BerkeleyCurtis/EECS249_HapticGlove/Sketches/Sketch1_PoC.jpg

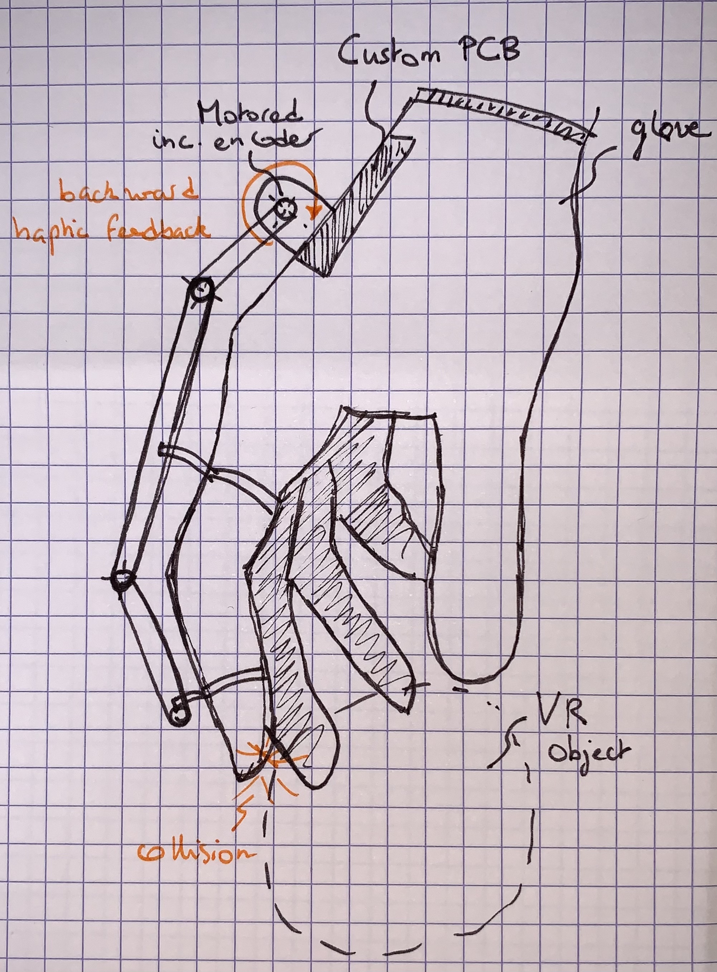
Sketches/Sketch1_PoC.jpg
