BerkeleyCurtis/EECS249_HapticGlove/CAD Models/Finger Servo Bracket.png

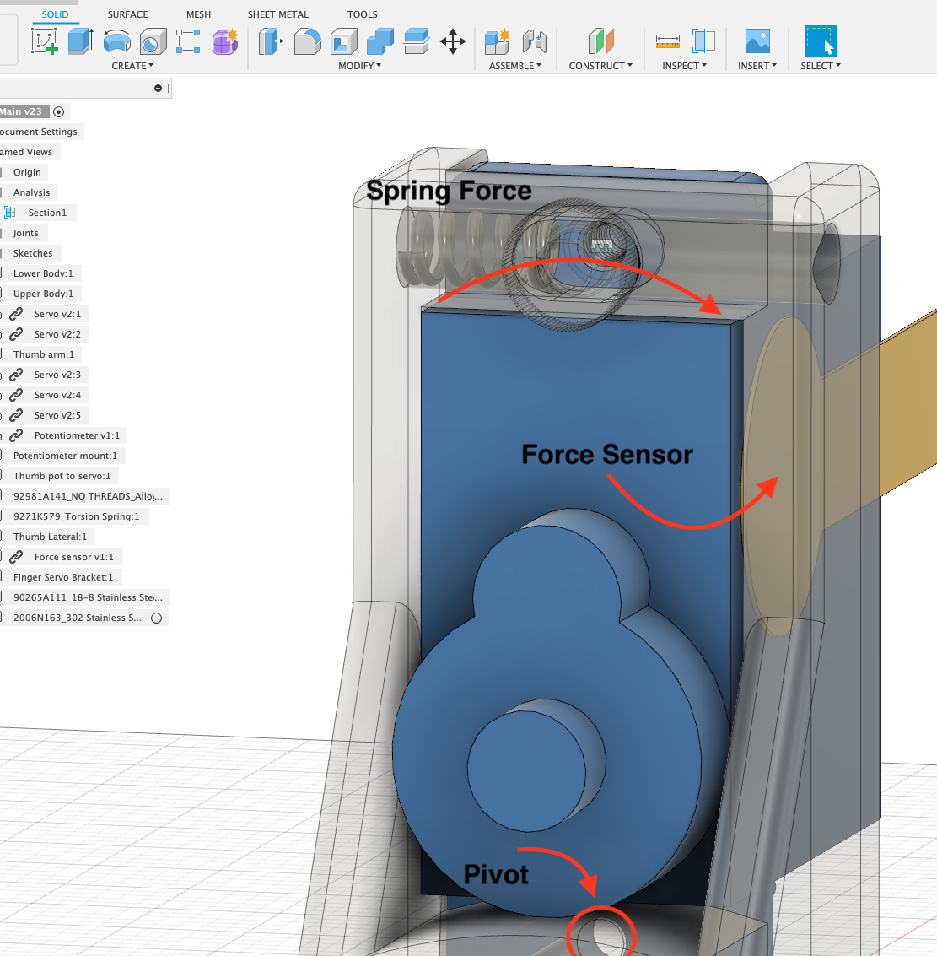
CAD Models/Finger Servo Bracket.png
