BerkeleyCurtis/EECS249_HapticGlove/Sketches/Architecture diag.pptx

RCA+RCD

IMU

Custom PCB

Micro USB

UART protocole

Computer Vision

Camera

USB

ESP32

Local machine

Optical flux

Robotic arm

Force sensor

ESP32 devkit

Force flux

GPIO

Object
