BerkeleyCurtis/EECS249_HapticGlove/PCB Files/Final PCB.png

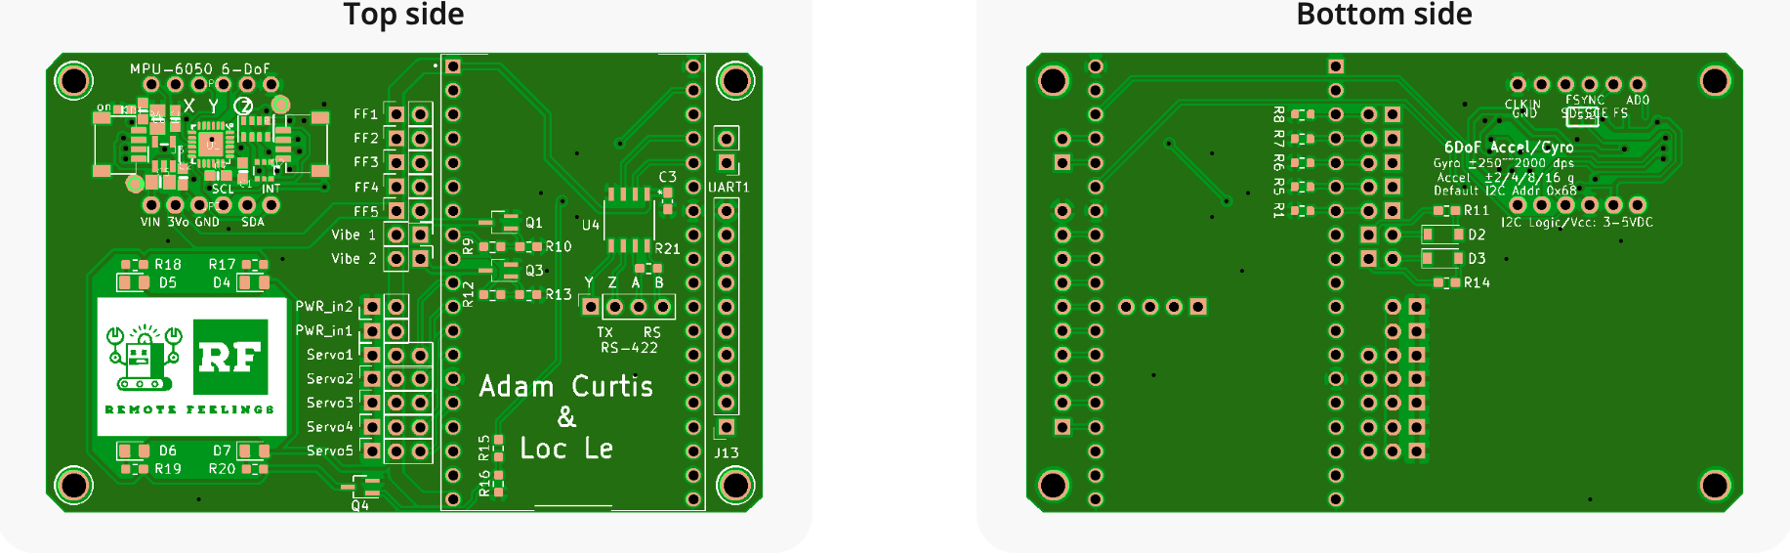
PCB Files/Final PCB.png
