BerkeleyCurtis/EECS249_HapticGlove/Sketches/Remote Feelings concurrent FSM.png

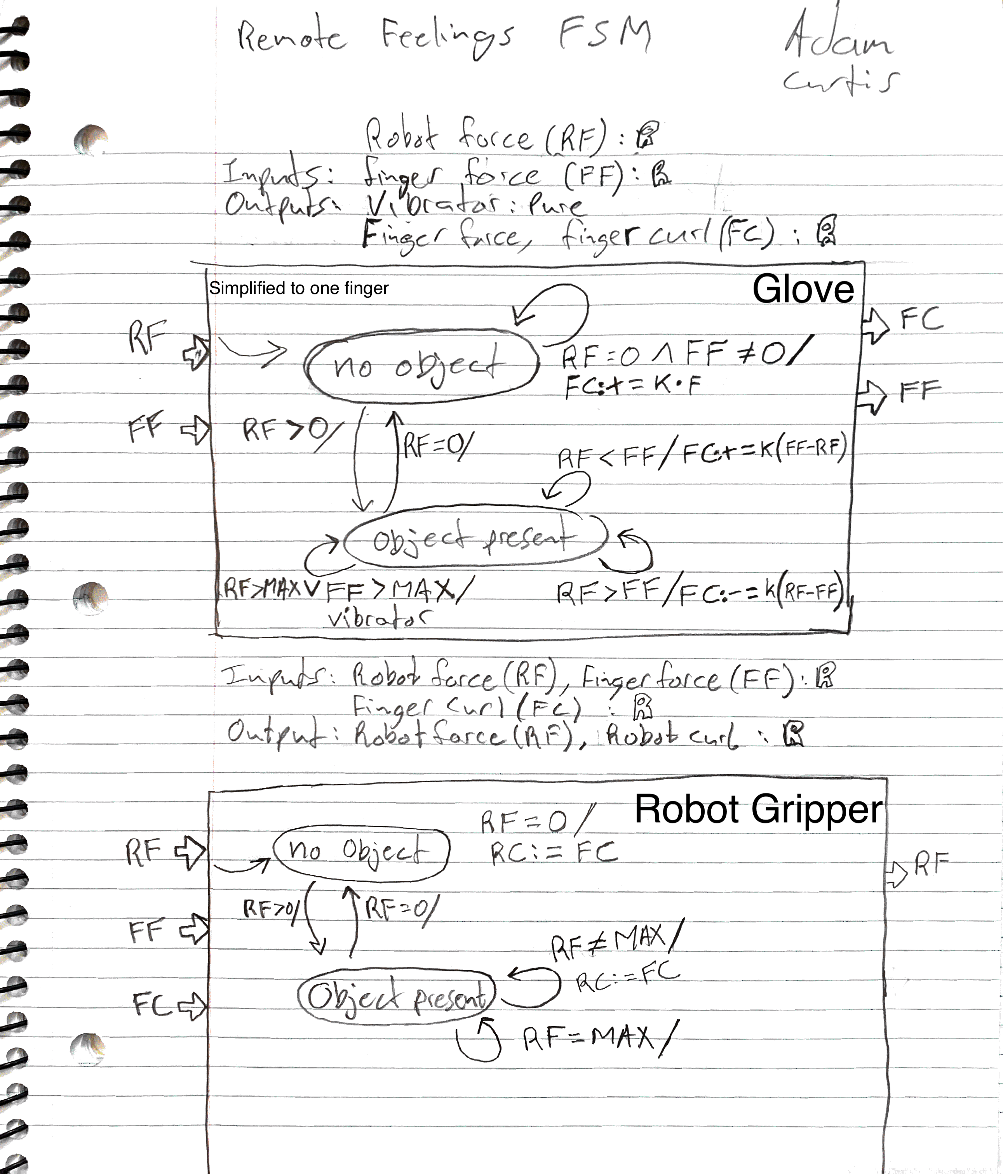
Sketches/Remote Feelings concurrent FSM.png
