BerkeleyCurtis/EECS249_HapticGlove/Sketches/System Diagram.png

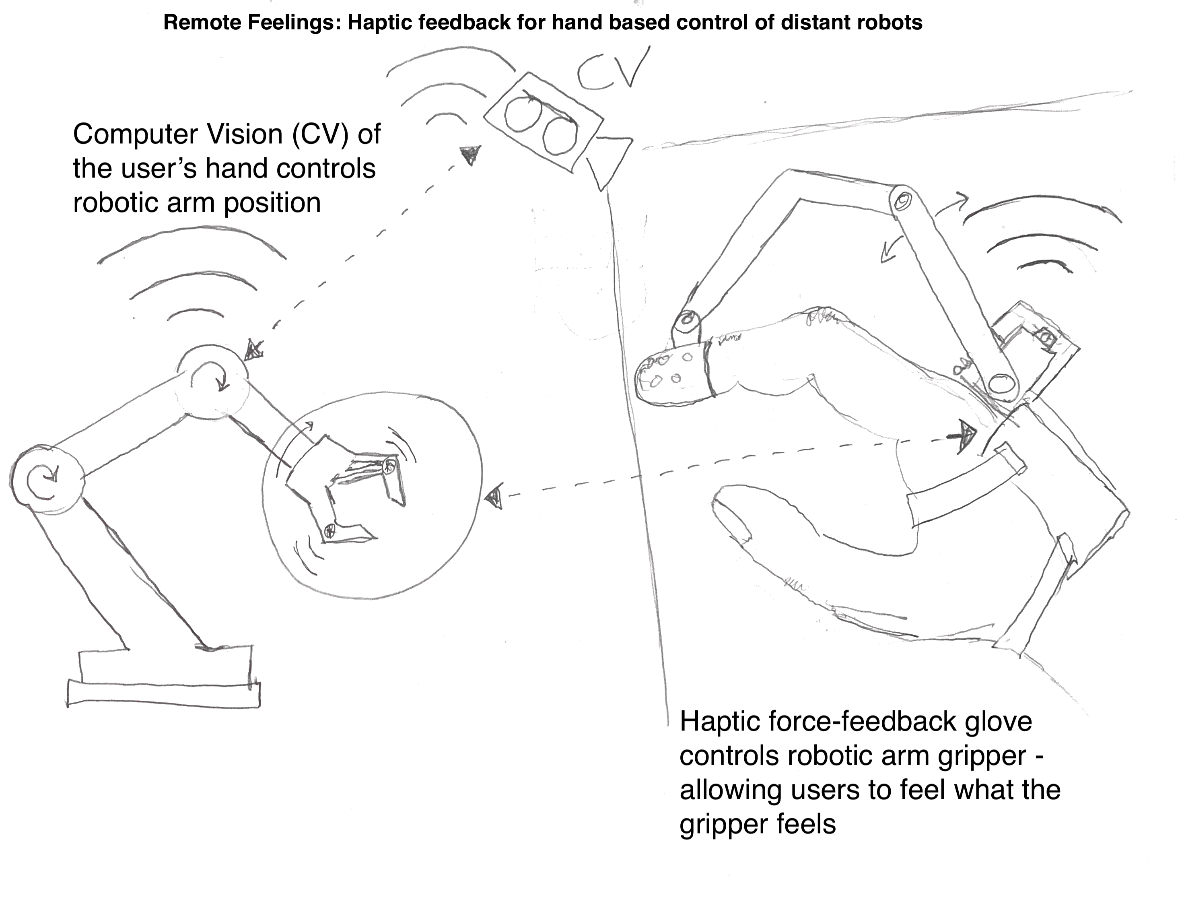
Sketches/System Diagram.png
