BerkeleyCurtis/EECS249_HapticGlove/Remote Feelings STLs/V2/Lower Main R-Hand 2.stl

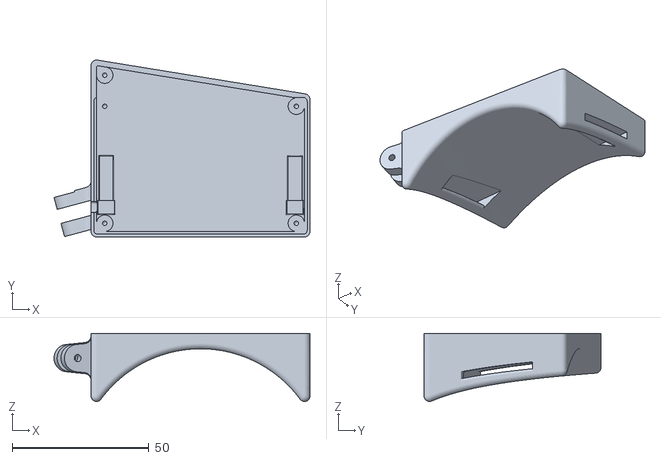
[picture p14: CAD file, 2021-12-15]
Remote Feelings STLs/V2/Lower Main R-Hand 2.stl
93.5 x 64.6 x 24.9
