BerkeleyCurtis/EECS249_HapticGlove/Remote Feelings STLs/V2/Upper Main R-Hand.stl

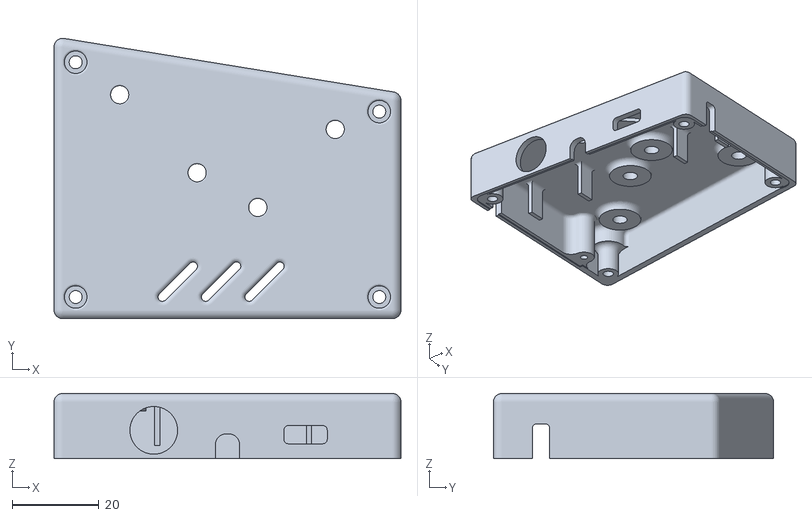
[picture p15: CAD file, 2021-12-15]
Remote Feelings STLs/V2/Upper Main R-Hand.stl
80.0 x 64.6 x 15.0
