BerkeleyCurtis/EECS249_HapticGlove/Remote Feelings STLs/V2/Index R-hand 2.stl

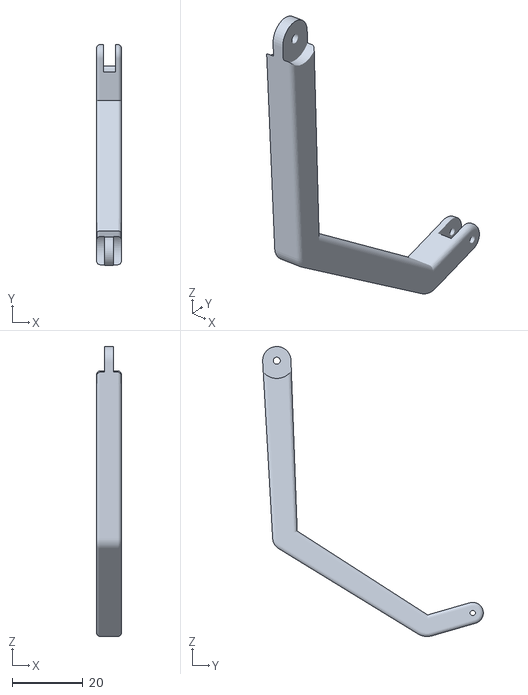
[picture p16: CAD file, 2021-12-15]
Remote Feelings STLs/V2/Index R-hand 2.stl
7.00 x 62.2 x 81.7
