BerkeleyCurtis/EECS249_HapticGlove/Remote Feelings STLs/V2/Thumb Bones 2.stl

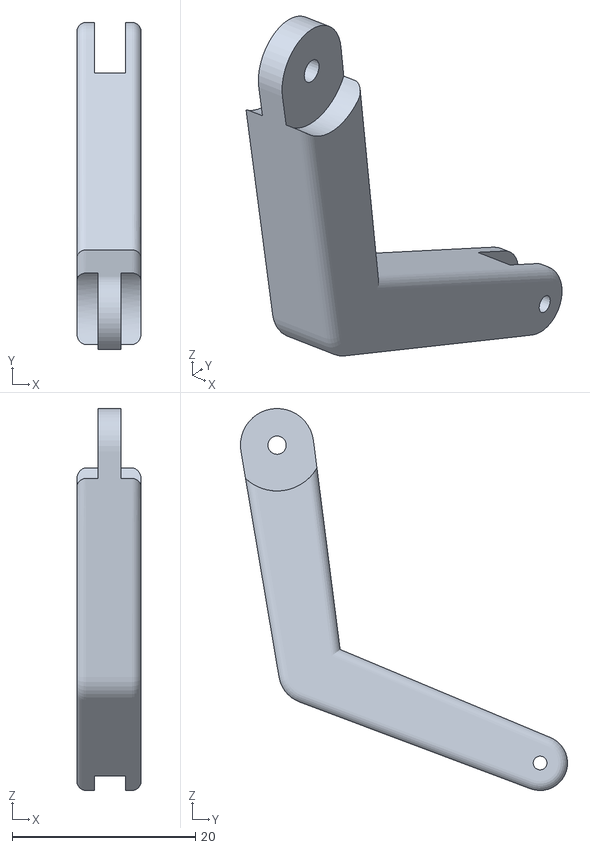
[picture p17: CAD file, 2021-12-15]
Remote Feelings STLs/V2/Thumb Bones 2.stl
7.00 x 35.7 x 41.7
