BerkeleyCurtis/EECS249_HapticGlove/Remote Feelings STLs/V2/Nano BLE Sense Mount.stl

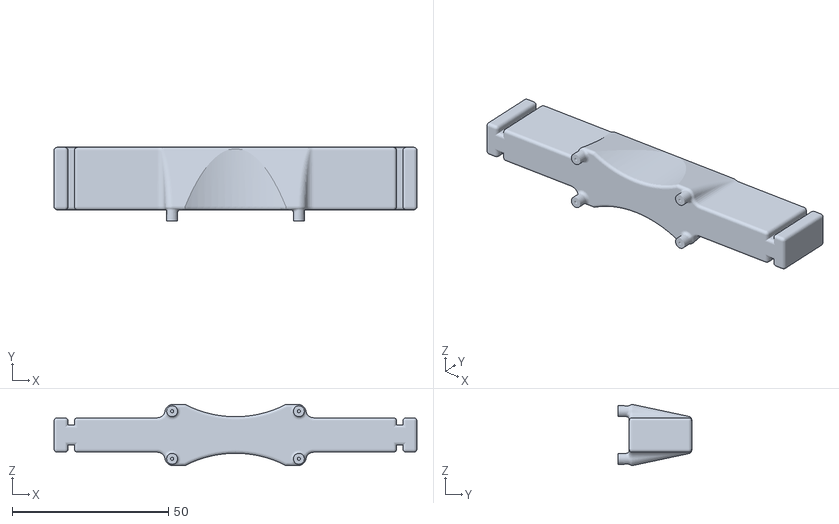
[picture p18: CAD file, 2021-12-15]
Remote Feelings STLs/V2/Nano BLE Sense Mount.stl
116.0 x 23.5 x 19.5
