BerkeleyCurtis/EECS249_HapticGlove/Remote Feelings STLs/V2/Thumb Arm.stl

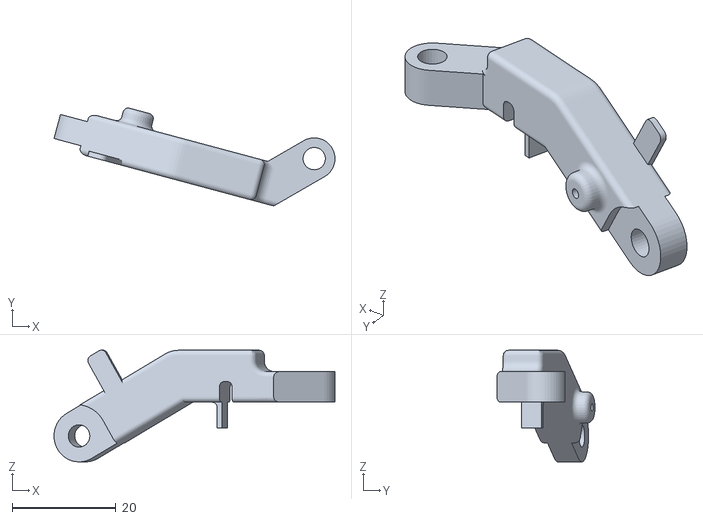
[picture p19: CAD file, 2021-12-15]
Remote Feelings STLs/V2/Thumb Arm.stl
54.1 x 18.9 x 21.5
