BerkeleyCurtis/EECS249_HapticGlove/Remote Feelings STLs/V2/R-Thumb bone short.stl

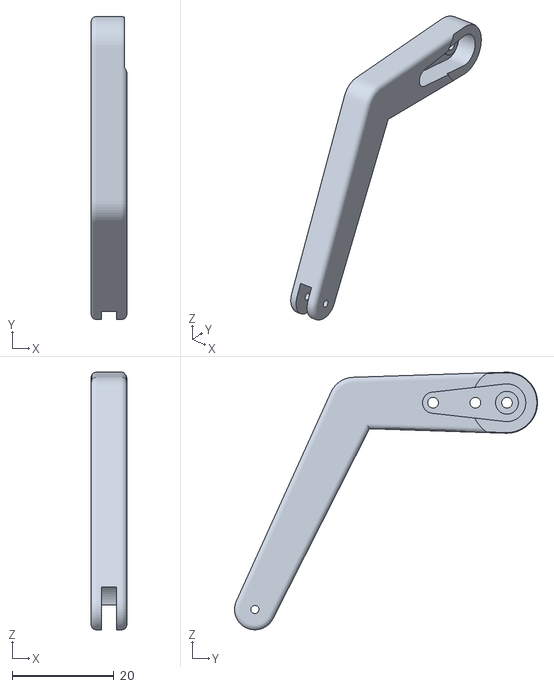
[picture p20: CAD file, 2021-12-15]
Remote Feelings STLs/V2/R-Thumb bone short.stl
7.00 x 59.5 x 50.6
