BerkeleyCurtis/EECS249_HapticGlove/Remote Feelings STLs/V2/Pinky R-Hand 1.stl

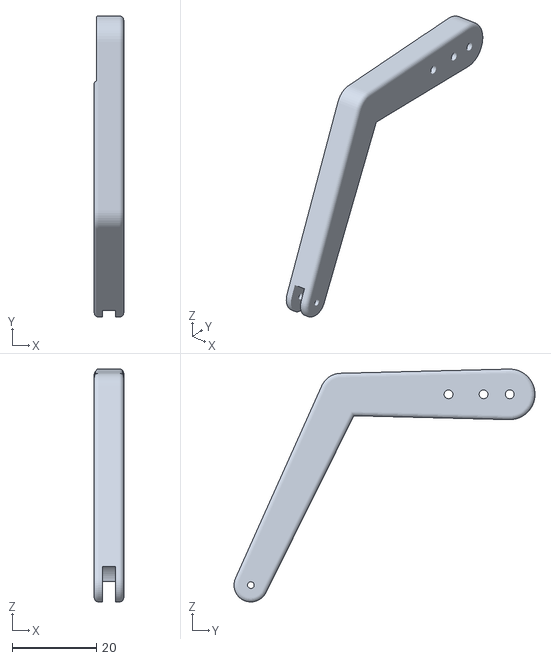
[picture p21: CAD file, 2021-12-15]
Remote Feelings STLs/V2/Pinky R-Hand 1.stl
7.00 x 71.3 x 55.2
