BerkeleyCurtis/EECS249_HapticGlove/Remote Feelings STLs/V2/Pinky R-Hand 2.stl

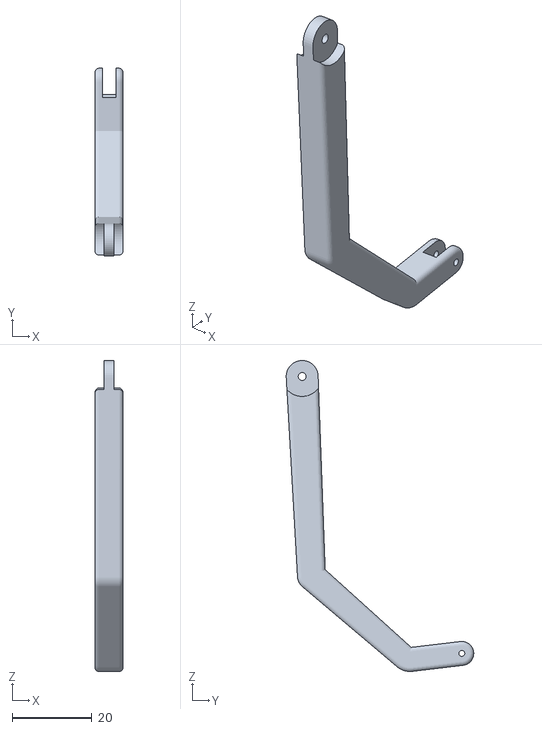
[picture p22: CAD file, 2021-12-15]
Remote Feelings STLs/V2/Pinky R-Hand 2.stl
7.00 x 46.9 x 77.8
