BerkeleyCurtis/EECS249_HapticGlove/Remote Feelings STLs/V2/Tappered Spring Cap.stl

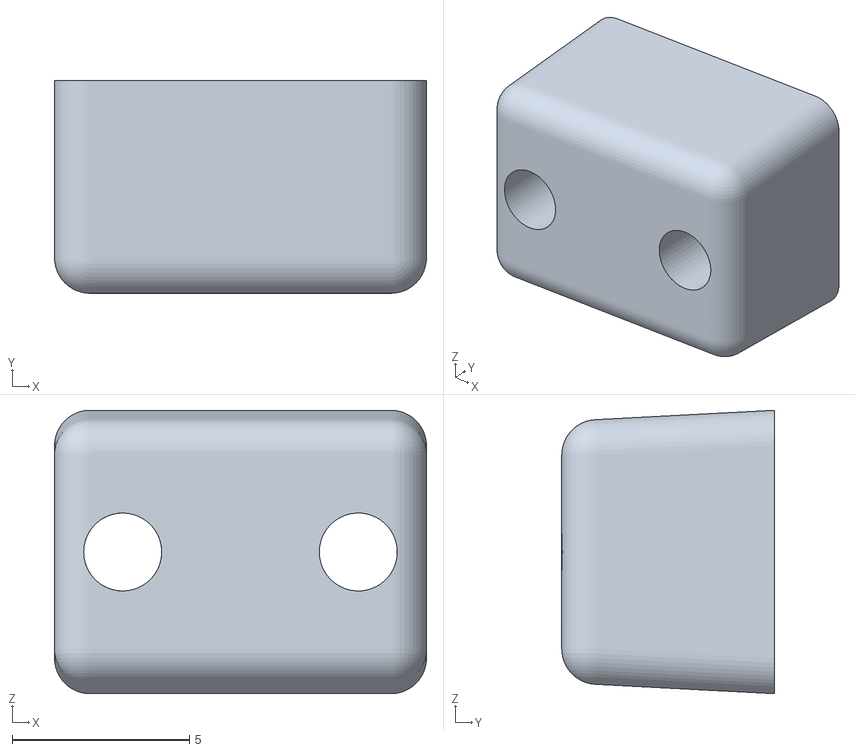
[picture p23: CAD file, 2021-12-15]
Remote Feelings STLs/V2/Tappered Spring Cap.stl
10.5 x 6.00 x 8.00
