BerkeleyCurtis/EECS249_HapticGlove/Remote Feelings STLs/V2/Thumb Spring Cap.stl

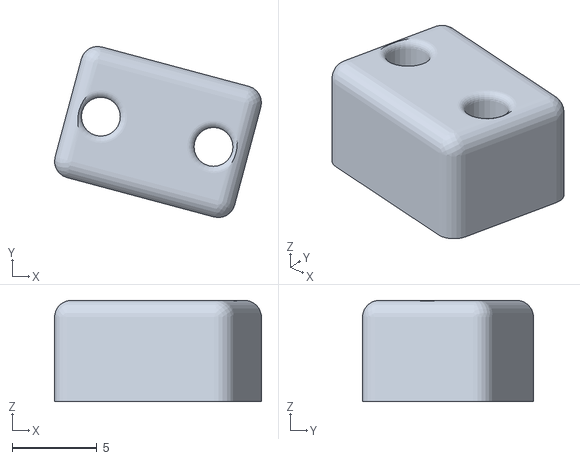
[picture p24: CAD file, 2021-12-15]
Remote Feelings STLs/V2/Thumb Spring Cap.stl
12.2 x 10.1 x 6.00
