BerkeleyCurtis/EECS249_HapticGlove/Remote Feelings STLs/V2/Finger Servo Bracket Clearance.stl

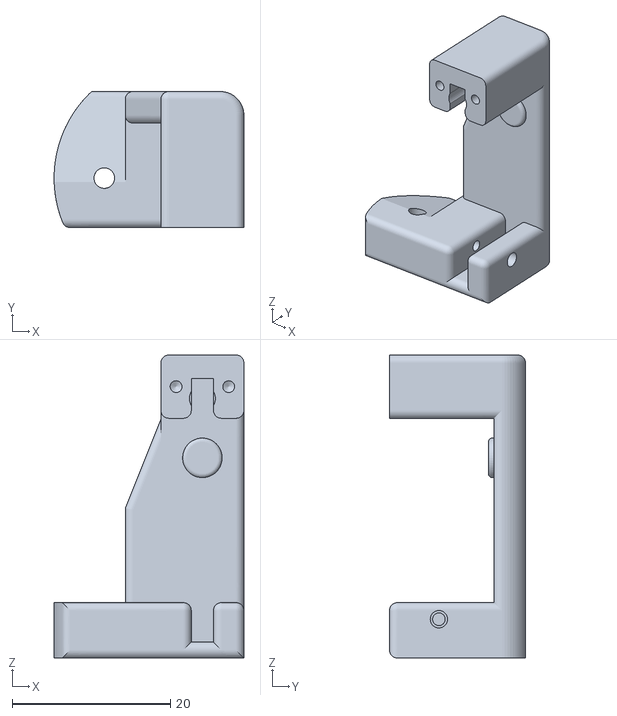
[picture p25: CAD file, 2021-12-15]
Remote Feelings STLs/V2/Finger Servo Bracket Clearance.stl
24.0 x 17.2 x 38.3
