BerkeleyCurtis/EECS249_HapticGlove/Remote Feelings STLs/V2/Ring R-Hand.stl

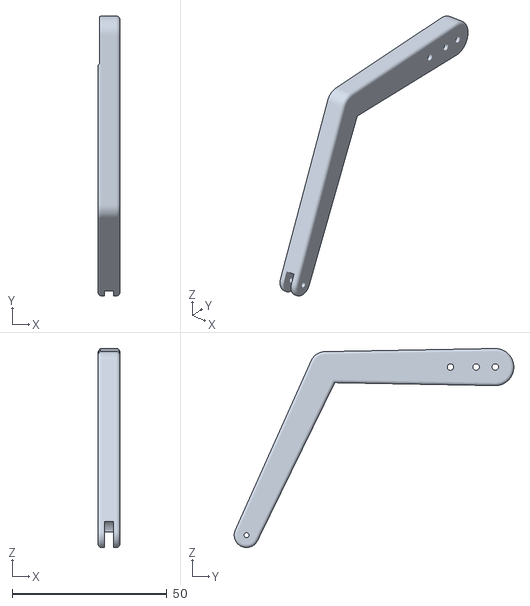
[picture p26: CAD file, 2021-12-15]
Remote Feelings STLs/V2/Ring R-Hand.stl
7.00 x 90.4 x 64.3
