BerkeleyCurtis/EECS249_HapticGlove/Remote Feelings STLs/V2/Thumb Bracket R-hand New.stl

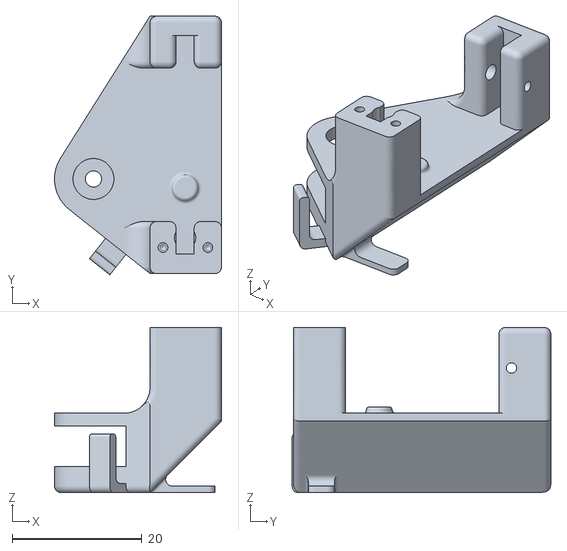
[picture p27: CAD file, 2021-12-15]
Remote Feelings STLs/V2/Thumb Bracket R-hand New.stl
25.7 x 39.8 x 25.4
