BerkeleyCurtis/EECS249_HapticGlove/Remote Feelings STLs/V2/Middle R-Hand.stl

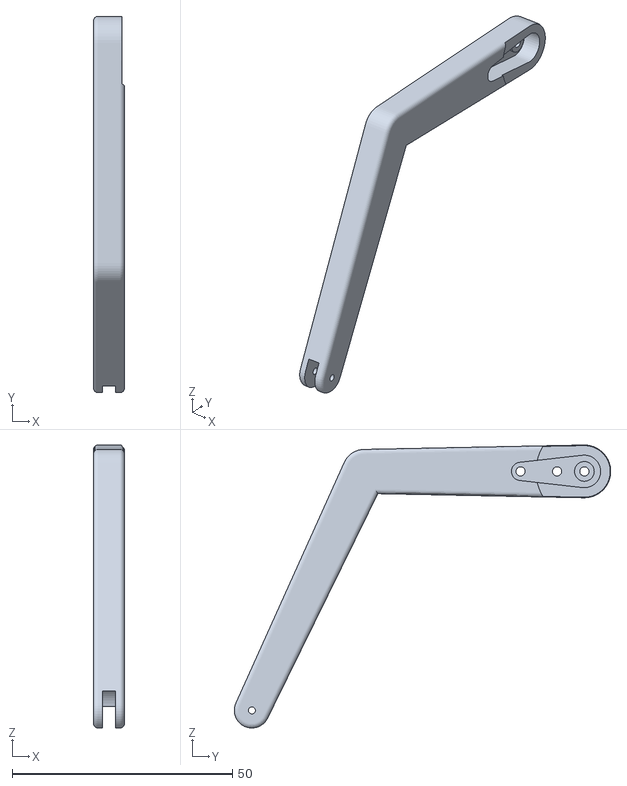
[picture p28: CAD file, 2021-12-15]
Remote Feelings STLs/V2/Middle R-Hand.stl
7.00 x 85.5 x 64.3
