BerkeleyCurtis/EECS249_HapticGlove/Remote Feelings STLs/V2/Finger Tip Connector.stl

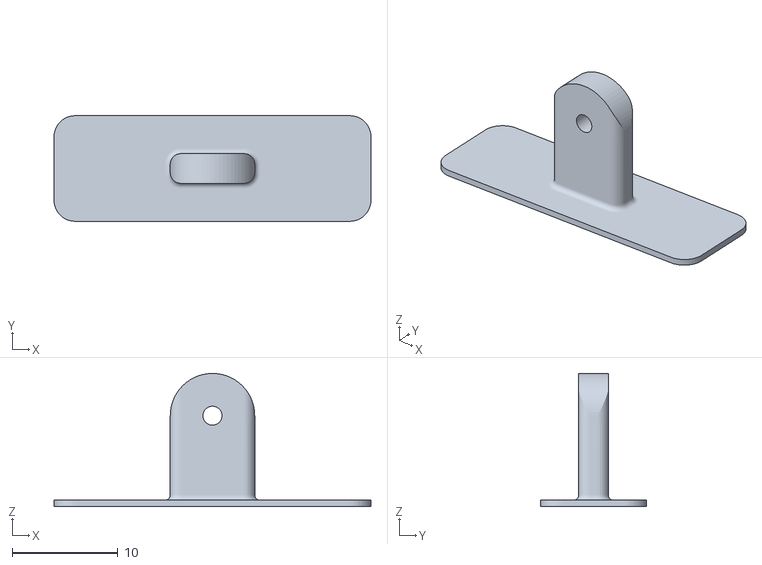
[picture p29: CAD file, 2021-12-15]
Remote Feelings STLs/V2/Finger Tip Connector.stl
30.0 x 10.0 x 12.6
