BerkeleyCurtis/EECS249_HapticGlove/Remote Feelings STLs/V2/Index R-Hand.stl

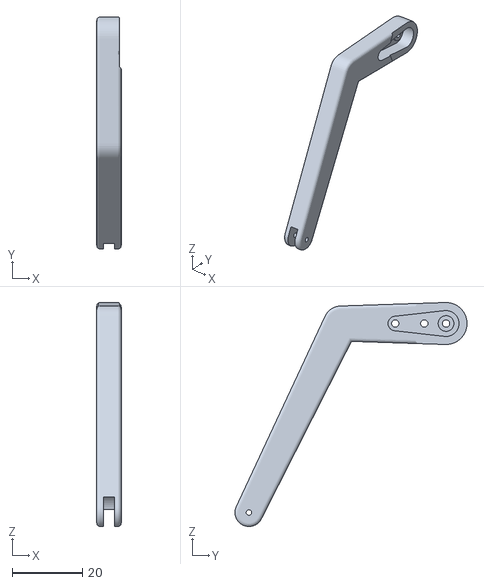
[picture p30: CAD file, 2021-12-15]
Remote Feelings STLs/V2/Index R-Hand.stl
7.00 x 66.3 x 63.9
