BerkeleyCurtis/EECS249_HapticGlove/Remote Feelings STLs/V2/Thumb Bones 1.stl

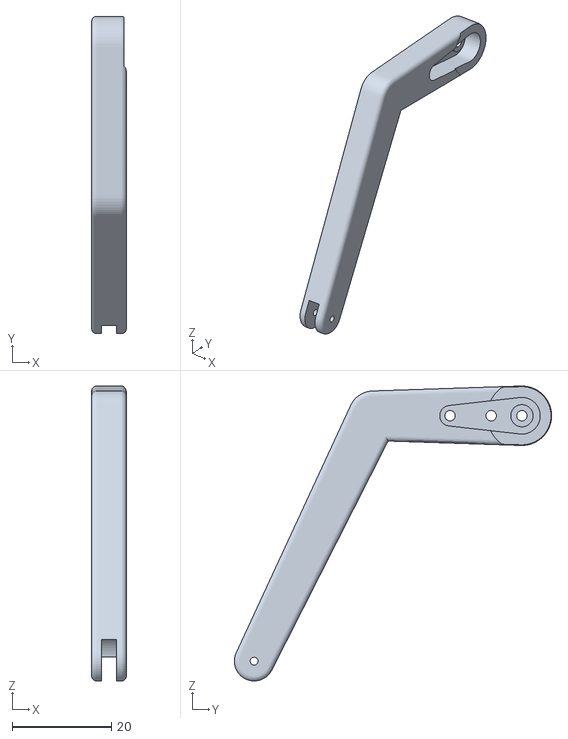
[picture p31: CAD file, 2021-12-15]
Remote Feelings STLs/V2/Thumb Bones 1.stl
7.00 x 64.0 x 59.5
