BerkeleyCurtis/EECS249_HapticGlove/(list of files, cad)

Other CAD files:
Remote Feelings STLs/V2/Lower Main R-Hand.stl
Remote Feelings STLs/V2/L-Hand Thumb Bracket.stl
Remote Feelings STLs/Old STL files/Hand Mount.stl
Remote Feelings STLs/Old STL files/Test Setup/Arm 1.stl
Remote Feelings STLs/Old STL files/Test Setup/Arm 2.stl
Remote Feelings STLs/Old STL files/Test Setup/Base.stl
Remote Feelings STLs/Old STL files/Test Setup/Servo bracket.stl
Remote Feelings STLs/Old STL files/Version 11:16/FingerServoMount.stl
Remote Feelings STLs/Old STL files/Version 11:16/LowerBodyAngled.stl
Remote Feelings STLs/Old STL files/Version 11:16/ThumbArmExtended.stl
Remote Feelings STLs/Old STL files/Version 11:16/ThumbServoBracket.stl
Remote Feelings STLs/Old STL files/Version 11:16/Upper Main.stl
Remote Feelings STLs/Old STL files/Version 11:8/Hand interface.stl
Remote Feelings STLs/Old STL files/Version 11:8/Potentiometer mount.stl
Remote Feelings STLs/Old STL files/Version 11:8/Potentiometer.stl
Remote Feelings STLs/Old STL files/Version 11:8/Servo Bracket.stl
Remote Feelings STLs/Old STL files/Version 11:8/Thumb Arm.stl
Remote Feelings STLs/V1/6mm Spring Cap.stl
Remote Feelings STLs/V1/Finger Bracket Cap.stl
Remote Feelings STLs/V1/Finger Servo Bracket.stl
Remote Feelings STLs/V1/Lower Body.stl
Remote Feelings STLs/V1/Upper body.stl
Remote Feelings STLs/V2/Lower Main screw 2.stl
Remote Feelings STLs/V2/Lower Main screw 3.stl
Remote Feelings STLs/V2/Lower main Screw 1.stl
