BerkeleyCurtis/EECS249_HapticGlove/(threads)

Thread 2 (2022-06-30):

Force response curve

BBBBBbruce, 2022-06-30:
Hello Adam,

I saw in your report you mentioned that the force response is non-linear because of the free pivot, I wonder if you draw any graphs to show the force on the finger versus torque/force produced by the motor?
