BerkeleyCurtis/EECS249_HapticGlove/Adams Code/RF_V3/include/MovingAvg.h

#ifndef MOVING_AVG_H
#define MOVING_AVG_H

#include <Arduino.h>


typedef struct {
  int window_size;
  int* queue; // queue[0] should be most recent value
} MovingAverage;

static MovingAverage* construct_moving_average(int window_size) {
  MovingAverage* avg = (MovingAverage*) malloc(sizeof(MovingAverage));
  avg->window_size = window_size;
  avg->queue = (int*) malloc(sizeof(int) * window_size);
  return avg;
}

static void deconstruct_moving_average(MovingAverage* avg) {
  free(avg->queue);
  free(avg);
}

static MovingAverage* add_moving_average_value(MovingAverage* avg, int val) {
  int i;
  for (i = avg->window_size - 1; i > 0; i--) {
    avg->queue[i] = avg->queue[i-1];
  }
  avg->queue[0] = val;
  return avg;
}

static float get_moving_average_value(MovingAverage* avg) {
  float total = 0;
  int i;
  for (i = 0; i < avg->window_size; i++) {
    total += avg->queue[i];
  }
  return total / avg->window_size;
}

static float update_moving_average_value(MovingAverage* avg, int val) {
  add_moving_average_value(avg, val);
  return get_moving_average_value(avg);
}

// void initializeMovingAvg(){
//   for(int i = 0; i < 5; i++){
//     avg_force[i] = construct_moving_average(listSize);
//   }
//   for(int j = 0; j < listSize; j++){
//     for(int i = 0; i < 5; i++){
//       forceAverage[i] = update_moving_average_value(avg_force[i], analogRead(FFPins[i]));
//     }
//   }
// }

#endif
