BerkeleyCurtis/EECS249_HapticGlove/(commit log)

2021-10-23 Proof of concept video for mechanical design
    This feedback control uses the binary input of a button. Perhaps improvements could be made using a force sensor instead.
2021-10-23 Added STL files
    STL files for proof of concept testing jig.
    [Arm 1.stl, Arm 2.stl, Base.stl, Servo bracket.stl]
2021-10-24 Google Drive link
    Created a public drive to share data sheets, schematics, footprints, and other PCB files
2021-11-07 Concurrent FSM
    Concurrent FSM illustrating the closed loop feedback control system between glove and robot gripper
2021-11-10 IMU code test + link 2 demo
2021-11-10 cv finger distance
2021-11-12 All PCB files needed to produce board
    Just send the Gerber zip file to a board manufacturer and they can make this board for you.
2021-11-12 Added Link For PCB BOM
2021-11-12 Added photo of thumb prototype
2021-11-12 review of glove architecture (one finger)
    Better compromise between DOF, simplicity of implementation, precision of feedback pulling resistance...
2021-11-13 Prototypes Update
2021-11-14 use keyboard input to contorl servo
2021-11-14 arduino file for keyboard contorl servo
2021-11-15 Force sensor integration
    Here's one possibility of how to use one force sensor to measure force in both directions.
    The servo can pivot a tiny bit, and a small spring keeps a pre-load on the force sensor.
    Hopefully the force sensor is accurate and repeatable enough that we don't need an overly large dead band in the middle.
2021-11-15 arm angle control servo rotate
2021-11-15 arduino code for arm angle control servo
2021-11-19 add a thread to control servo
2021-11-19 thread and latency debug
2021-11-19 pose control uwithout thread
2021-11-30 Working force sensor code
    This code reads a force sensor and drives a servo accordingly.
    It's just a proof of concept to see if the force sensors would give useful data.
2021-12-01 Updated Code for all fingers
2021-12-03 organize + interpolate arduino code
2021-12-03 Pulled down update for ESP32_firmware
2021-12-03 Linking to last update of submodule ESP32_firmware
2021-12-03 Retrieving ESP32 firmware submodule (reading gripper+glove values)
2021-12-06 Stable Baseline
    This version works. Currently robotControl() function uses averaging for moving fingers.
    -Need to add force input from the gripper
    -Need to implement derivative control
    -How to avoid re-using old force measurements?
    [ForceFuncs.h, MotionFuncs.h, MovingAvg.h, adc_to_newtons.h, calibration.h, main.cpp, pin_config.h]
2021-12-06 Glove can now control gripper
    Demo video added
2021-12-10 Newest Versions
    Includes functions to drive hacked servos
2021-12-10 Fingers are puched back!
2021-12-15 All parts for Right and Left gloves
    Most R/L handed parts can be mirrored in a slicers, but the upper main cannot because the cutout for usb and power cable do not flip.
    [6mm Spring Cap.stl, Arm 1.stl, Arm 2.stl, Base.stl, Finger Bracket Cap.stl, Finger Servo Bracket Clearance.stl, Finger Servo Bracket.stl, Finger Tip Connector.stl]
2021-12-15 Old STLs not relevant anymore
    [Arm 1.stl, Arm 2.stl, Base.stl, Servo bracket.stl]
2021-12-15 Put folder in wrong spot
    [ForceFuncs.h, MotionFuncs.h, MovingAvg.h, adc_to_newtons.h, calibration.h, main.cpp, pin_config.h]
2021-12-15 Updated notice about forthcoming CAD models
2021-12-27 Second PCB gerbers and BOM
2022-08-01 Refactored and updated code
    Includes developments for VR and robot control and a manual calibration function with descriptive comments
